mhbvr/hv_flyback_converter/docs/img/derivation_sheet_1.jpg

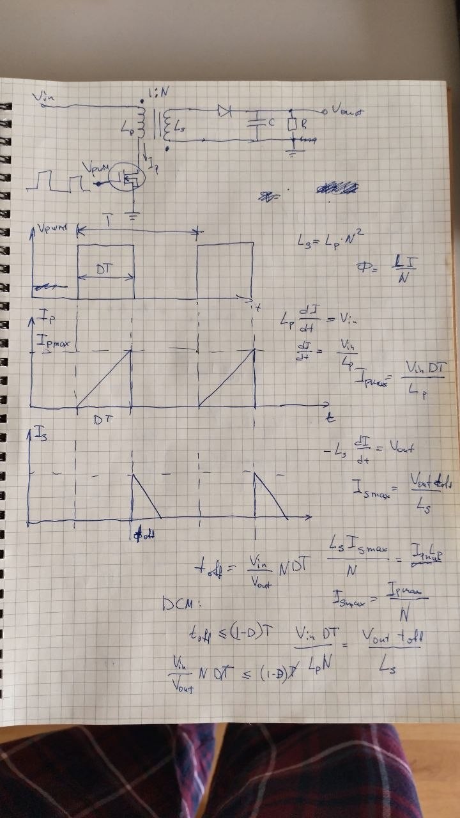
docs/img/derivation_sheet_1.jpg
