mhbvr/hv_flyback_converter/docs/img/derivation_sheet_2.jpg

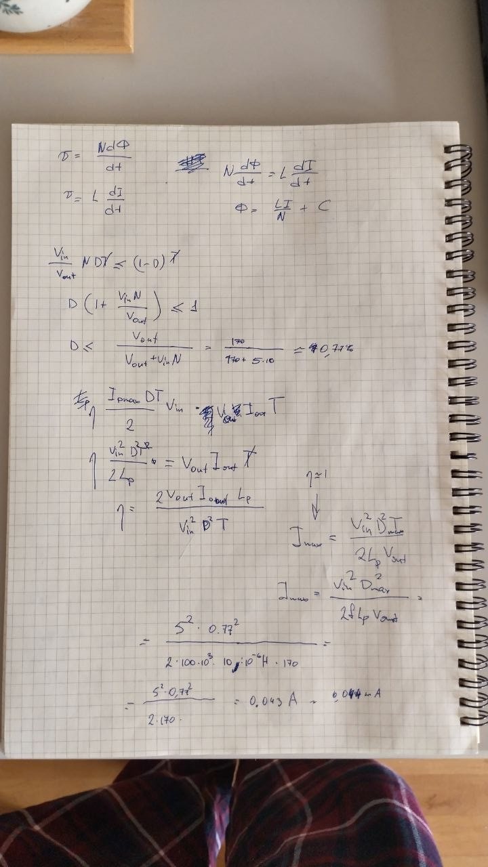
docs/img/derivation_sheet_2.jpg
