mhbvr/hv_flyback_converter/README.md

# HV Flyback Converter

A flyback boost converter that generates the high-voltage DC anode supply for
**nixie tubes** from a low-voltage input. The target is about 170 V from a 5 V
supply with a limited power budget.

The converter is a boost stage built around a coupled inductor (the
"flyback transformer"). It runs in **discontinuous conduction mode (DCM)**
under closed-loop voltage regulation.

## Repository layout

| Path | Contents |
|---|---|
| `docs/theory.md` | Derivation of the DCM design equations: peak currents, demagnetization time, DCM limit, maximum output current, voltage stresses and output ripple |
| `docs/datasheets/` | Links to component datasheets |
| `prototype1/` | First bench prototype: components and ideal characteristics |
| `docs/img/` | Circuit diagram and the original hand-written derivation sheets |
