mhbvr/hv_flyback_converter/docs/datasheets/README.md

# Datasheets

Manufacturer datasheets for the parts used in the prototypes.

| Part | Manufacturer | Datasheet |
|---|---|---|
| DA2033-AL flyback transformer | Coilcraft | [da2032.pdf](da2032.pdf) (covers DA2032/33/34-AL) |
| QH05TZ600 diode | Power Integrations | [qh05tz600.pdf](qh05tz600.pdf) |
| CSD18533KCS MOSFET | Texas Instruments | [csd18533kcs.pdf](csd18533kcs.pdf) |
| MCP1407 gate driver | Microchip | [MCP1407.pdf](MCP1407.pdf) (MCP1406/07) |
| MKS4 film capacitor | WIMA | [WIMA_MKS_4.pdf](WIMA_MKS_4.pdf) |
| 1000 µF 50 V electrolytic capacitor | Nichicon | series not identified yet |
