mhbvr/hv_flyback_converter/(list of files, drawings)

Other design files:
prototype1/simulation/models/CSD18533KCS.OLB
