mhbvr/hv_flyback_converter/(commit log)

2026-11-09 WIP model simultation
    [comverter model.sch]
2026-11-09 Set PWM source V2 to 100 kHz (2 us on / 8 us off)
    V2 had TH=2 ms / TL=8 ms, i.e. 100 Hz. Use microseconds so the
    converter switches at the intended 100 kHz with 20% duty cycle.
    Claude-Session: https://claude.ai/code/session_01MDSEE3FDcmKwCKaZeg23EU
    [comverter model.sch]
2026-11-09 Use power-MOSFET parameters for T1 and 2.2 uF output capacitor
    T1 (Kp=2e-5, W=L=1um) could only conduct ~53 uA at Vgs=3.3 V, so the
    switch never turned on and no energy reached the transformer.
    Set Vt0=1.5 V, Kp=20 (Rds_on ~30 mOhm) and Cbd=300 pF so the drain
    node has some capacitance for the leakage-inductance energy.
    C1 was 2.2 mF (tau = 2.2 s with the 1 kOhm load), so the output could
    not build up within the 20 ms run; use 2.2 uF.
    Verified with an equivalent ngspice netlist: Vout ~21.6 V into 1 kOhm,
    ~70 mV ripple, 0.99 A peak magnetizing current, ~65 V drain peak.
    Claude-Session: https://claude.ai/code/session_01MDSEE3FDcmKwCKaZ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
    [comverter model.sch]
2026-11-13 Remove uncomplete aftifacts
    [comverter model.sch]
2026-11-13 Add README and DCM flyback theory notes
    Add a short README and docs/theory.md with the derivation of the basic
    flyback DCM formulas (peak currents, demagnetization time, DCM limit,
    maximum output current, efficiency from measured duty cycle), plus a
    circuit diagram and the original hand-written sheets.
    Claude-Session: https://claude.ai/code/session_01MDSEE1bQVnaz4E4X62hEwW
2026-11-13 Add DCM waveform graphs to theory notes
    Add a figure with the PWM signal, primary current and secondary current
    over two switching periods, as requested in PR review.
    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
2026-11-13 Address review comments on README and theory notes
    Drop the transcription note from the theory intro, describe the converter
    as a boost stage rather than a buck-boost, and remove the Status section.
    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
2026-11-13 Add prototype 1 description and ideal characteristics
    Add prototype1/README.md with the component list and the characteristics
    computed from the lossless DCM theory, and docs/datasheets/README.md with
    links to the component datasheets.
    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
2026-11-13 Add ngspice simulation of prototype 1
    Add the netlist, datasheet-based models for the transformer, MOSFET, diode
    and gate driver, the prototype schematic, a drawing of the simulated
    circuit, a waveform plot and the simulation write-up in the README.
    Point the datasheet index at the PDFs now in the repository.
    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
2026-11-13 MOSFET model
    [CSD18533KCS.OLB]
2026-11-13 Add simple ngspice model of prototype 1
    A flat 17-element netlist without vendor models or subcircuits: the
    MOSFET is a switch with constant charge-equivalent capacitors taken from
    the datasheet, and the output diode is a plain SPICE diode. The README in
    the directory documents every value and compares the results with the
    detailed model and the ideal theory.
    Claude-Session: https://claude.ai/code/session_01MDSEDybwgnco3ftRG8pohu
2026-11-13 Rename simulation to simulation_vendor and add vendor MOSFET trial
    Add the simple netlist with the unmodified TI PSpice model of the
    CSD18533KCS and PSpice compatibility enabled through .spiceinit. The
    model does not load in ngspice 42; the README in the directory reports
    the issues found and the investigation. Nothing is fixed and the vendor
    file is unchanged. Path references in the other READMEs follow the
    rename.
    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
    [CSD18533KCS.OLB]
2026-11-13 Keep only the simple simulation, with a datasheet-based MOSFET model
    Remove simulation_vendor. In the simple netlist the MOSFET is now the
    ngspice VDMOS element with parameters taken from or fitted to the
    CSD18533KCS datasheet. The README in simulation_simple explains every
    parameter and checks the model against the datasheet; the prototype
    README points to it.
    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
    [CSD18533KCS.OLB]
